mintynet/value-pasta-auto/Hardware/teensy-ecu schematic v1.1.png

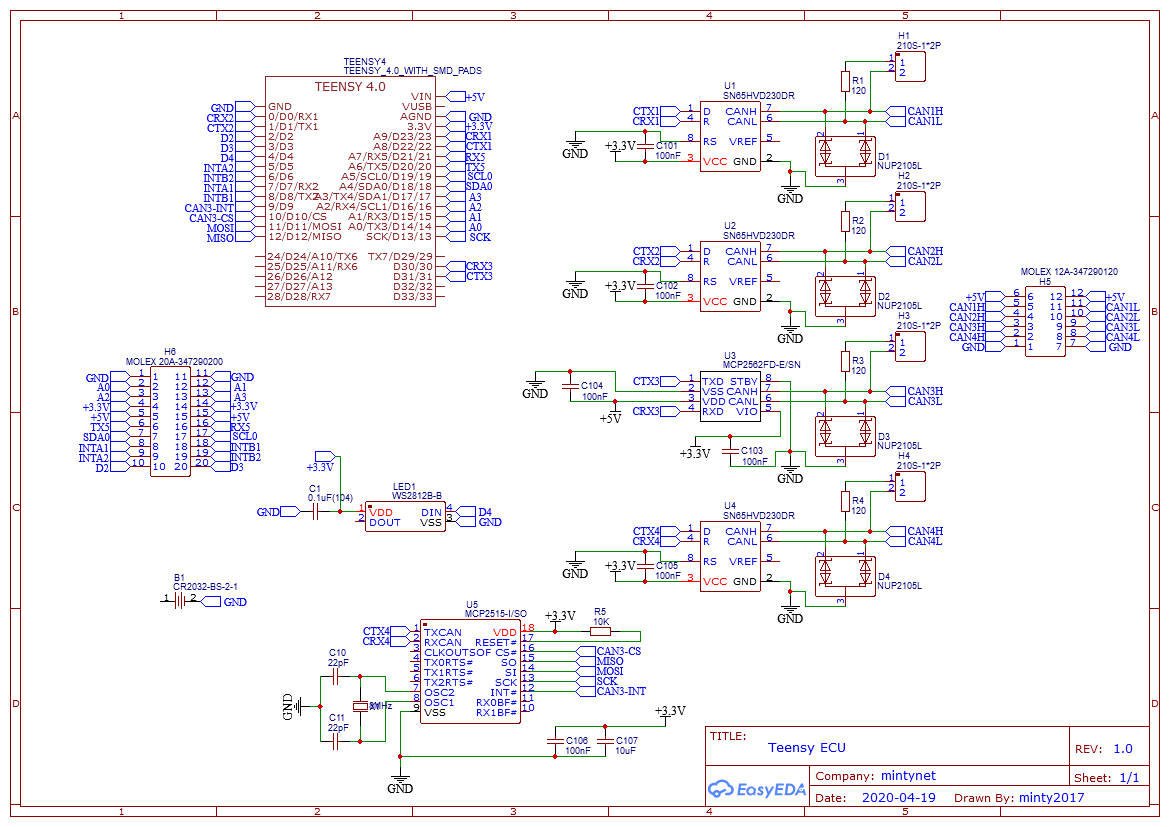
Hardware/teensy-ecu schematic v1.1.png
