mintynet/value-pasta-auto/Hardware/teensy-ecu v1.1.png

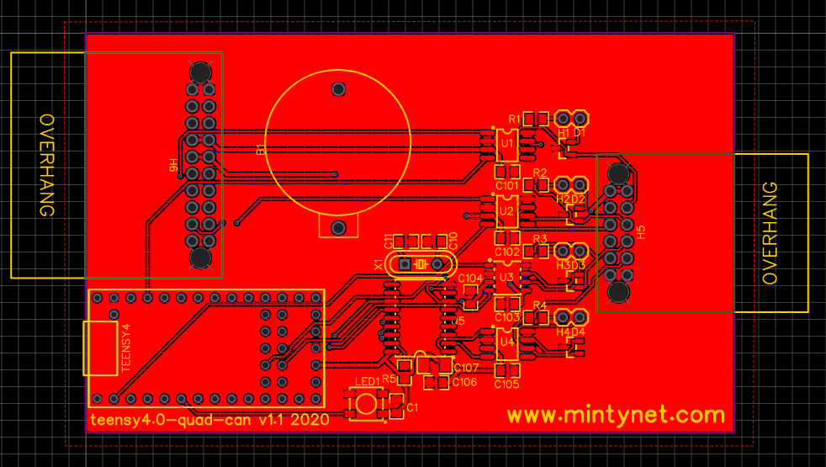
Hardware/teensy-ecu v1.1.png
