mintynet/value-pasta-auto/Software/Nextion-Serial-Passthrough/Nextion-Serial-Passthrough.ino

                                                  // Teensyduino 1.56
                                                  // Arduino 1.8.19

/**************************************************
 setup()
**************************************************/
void setup() {
  // initialize both serial ports:
  Serial.begin(250000);
  Serial5.begin(250000);
}

/**************************************************
 loop()
**************************************************/
void loop() {
  // read from port 5, send to port 0:
  if (Serial5.available()) {
    int inByte = Serial5.read();
    Serial.write(inByte);
  }

  // read from port 0, send to port 5:
  if (Serial.available()) {
    int inByte = Serial.read();
    Serial5.write(inByte);
  }
}

/**************************************************
 END FILE
**************************************************/
