mintynet/value-pasta-auto/Software/VPA_Bluetooth_Car/BluetoothOrders.h

// BluetoothOrders.h

#ifndef _BLUETOOTHORDERS_h
#define _BLUETOOTHORDERS_h

#if defined(ARDUINO) && ARDUINO >= 100
  #include "arduino.h"
#else
  #include "WProgram.h"
#endif

#define ACTION_MOVE   'A'
#define ACTION_STOP   'B'
#define ACTION_RGB   'C'
#define ACTION_BUZZER   'D'
#define ACTION_ULTRASONIC   'E'
#define ACTION_LIGHT_TRACING   'F'
#define ACTION_TRACKING   'G'
#define ACTION_CAR_MODE   'H'
#define ACTION_GET_VOLTAGE   'I'
#define ECHO_OK   'J'
#define ACTION_NONE   'K'

#define MODE_NONE  0
#define MODE_GRAVITY  1
#define MODE_ULTRASONIC  2
#define MODE_TRACKING  3

#endif
