mintynet/value-pasta-auto/(commit log)

2021-01-06 updated gateway function on Gateway ECU
    Minor fixes to the other ECUs,
    For the Gateway ECU new mcp_minty.h allows faster CAN send messages
    [chassis-Timer-T4.ino, gateway-T4.ino, mcp_minty.h, powertrain-Timer-T4.ino]
2021-01-14 Added reboot CAN msg
    Added reboot CAN msg and reboot from gateway serial port
    [body-Timer-T4.ino, chassis-Timer-T4.ino, gateway-T4.ino, powertrain-Timer-T4.ino]
2021-01-16 Fix nextion reads
    Fix issues with Nextion serial reads
    [body-Timer-T4.ino, gateway-T4.ino, mcp_minty.h, nextion.ino, powertrain-Timer-T4.ino]
2021-02-18 Added Bill of Materials
2021-12-28 Update BOM
    Includes both plug and socket for connectors
2022-01-14 Switch debounce for chassis ECU
2022-05-28 Update README.md
    Added details of the wiring between ECU and I/O
2022-05-28 update chassis.hmi for discovery
2022-06-03 remove miss name gerber zip
2022-06-17 Update to switch bounce code
    For chassis ECU part
